martykube/maiana/latest/CAD/UARTBreakout/jlcpcb-3.0/uart-breakout-3.0-BOM-JLCPCB.csv

Comment | Designator | Footprint | LCSC Part #
1uF 50V X5R | C1,C2 | 0603 | C15849
0.1uF 50V X7R | C4,C5 | 0603 | C1591
SMBJ14CA | D1 | SMB | C152105
WSB5508L-2/TR | D2 | SOD-123 | C239542
BZT52C3V0S 3V zener | D3 | SOD-323 | C266575
BSMD1206-050-16V | F1 | 1206 | C883124
10118194-0001LF | J1 | USB Micro-B | C132563
75R | R8 | 0603 | C4275
CH340N | U$1 | SOIC-8 | C2977777
SRV05-4 | U$4 | SOT-23-6 | C2836319
SE8533X2-HF | U1 | SOT-23 | C115016
