martykube/maiana/latest/CAD/NMEA0183Breakout/Rev7.1/jlcpcb/nmea0183-adapter-7.1-BOM-JLCPCB.csv

Comment | Designator | Footprint | LCSC Part #
0.1uF 50V X7R | C1,C2,C3,C9,C10,C11 | 0603 | C1591
1uF 50V X5R | C4,C5,C6,C7,C8 | 0603 | C15849
WSB5508L-2/TR | D1 | SOD-123 | C239542
SMBJ16CA | D2 | SMB | C113990
RJ45 FG RJ-055-1 | J1 | RJ-82A86MMNL | C7205195
10118194-0001LF | J3 | USB_Micro-B | C132563
LED green | LED1,LED2,LED3,LED4 | 1206 | C14641
BSS138LT1G | Q1 | SOT-23 | C82045
AO3401A | Q2 | SOT-23 | C15127
10k | R1,R2 | 0603 | C25804
2.2k | R3,R4,R5,R6 | 0603 | C4190
BSMD1206-050-16V | TH1 | 1206 | C883124
SRV05-4 | U1 | SOT-23-6 | C2836319
CH340N | U2 | SO-8 | C2977777
ADUM121N1BRZ-RL7 | U3 | SOIC-8 | C190783
TJ5205SF5-5.0 | U4 | SOT-23-5 | C126091
SE8533X2-HF | U5 | SOT-23 | C115016
DS8921M/NOPB | U6 | SOIC-8 | C133584
