martykube/maiana/latest/CAD/NMEA2000Breakout/Rev8.1/jlcpcb/nmea2000-adapter-8.1-BOM-JLCPCB.csv

Comment | Designator | Footprint | LCSC Part #
0.1uF 50V X7R | C1,C2,C3,C11,C12,C13 | 0603 | C1591
20pF 50V C0G | C4,C5 | 0603 | C91702
1uF 50V X5R | C6,C7,C8,C9,C10 | 0603 | C15849
LED green | D1,D2,D3,D4 | 1206 | C14641
PESD1CAN-UX | D5 | SOT-323 | C152727
SMBJ16CA | D6 | SMB | C113990
B5819W SL | D8 | SOD-123 | C8598
RJ45 FG RJ-055-1 | J2 | RJ-82A86MMNL | C7205195
10118194-0001LF | J3 | USB_Micro-B | C132563
BSS138LT1G | Q1,Q3 | SOT-23 | C82045
AO3401A | Q2 | SOT-23 | C15127
2.2k | R1,R2,R3,R4 | 0603 | C4190
10k | R5,R6,R7,R8,R9,R10 | 0603 | C25804
0R | R11,R12 | 0603 | C21189
CL-SB-12B-01 | SW1,SW2 | CL-SB-12B-01T | C5619703
1977066-1 | SW3 | TE_1977066-1 | C2972219
BSMD1206-050-16V | TH1 | 1206 | C883124
STM32L432KBU6 | U1 | QFN-32 | C94784
MCP2515-I/ST | U2 | TSSOP-20 | C15193
MCP2551-I/SN | U3 | SOIC-8 | C7376
SRV05-4 | U4 | SOT-23-6 | C2836319
CH340N | U5 | SO-8 | C2977777
ISO7721DR | U6 | SOIC-8 | C366164
TJ5205SF5-5.0 | U7 | SOT-23-5 | C126091
SE8533X2-HF | U8 | SOT-23 | C115016
X322516MOB4SI 16MHz | Y1 | 3225 | C12668
