martykube/maiana/latest/CAD/Board-12.0.1/jlcpcb/transponder-12.0.1-BOM-JLCPCB.csv

Comment | Designator | Footprint | LCSC
1575AT43A0040001E | AE1 | ANT_1575AT_JOT
91pF | C2 | C_0603_1608Metric | C701317
36pF | C15 | C_0603_1608Metric | C134070
2.2nF | C16 | C_0603_1608Metric | C77033
20pF | C21 | C_0603_1608Metric | C77030
16pF | C22 | C_0603_1608Metric | C327125
10uF | C29 | C_0805_2012Metric | C18185759
4pF | C32 | C_0603_1608Metric | C437534
2.2pF | C33 | C_0603_1608Metric | C282246
2pF | C1,C37 | C_0603_1608Metric | C81437
470pF | C13,C18,C20 | C_0603_1608Metric | C85979
110pF | C14,C17 | C_0603_1608Metric | C327208
22nF | C19,C31 | C_0603_1608Metric | C106222
22uF | C28,C38 | C_0805_2012Metric | C20416420
0.1uF,0.1uf | C3,C9,C11,C27,C34,C35 | C_0603_1608Metric | C14663
7.5pF | C4,C36 | C_0402_1005Metric | C88938
13pF | C5,C6 | C_0402_1005Metric | C130119
2.2uF | C7,C10,C23,C24,C25,C26,C30,C39 | C_0603_1608Metric | C380321
100pF | C8,C12 | C_0603_1608Metric | C71664
D3V3X8U9LP3810-7 | CR1 | U-DFN3810-9TYPE_B_DIO | C1973794
SMBJ16CA | D1 | DIOM4336X265N | C113990
BAT54WS | D3,D4 | D_SOD-323 | C124205
LDFPVR | IC1 | SON65P200X200X100-7N-D | C2969978
CON-SMA-EDGE-S | J3 | RFSOLUTIONS_CON-SMA-EDGE-S
RJ-82A86MMNL | J4 | RJ-82A86MMNL | C7205195
2.2uH AFL160808-2R2MLH | L4 | L_0603_1608Metric | C55265173
13nH | L5 | L_0603_1608Metric | C701184
39nH | L6 | L_0603_1608Metric | C86134
20nH | L7 | L_0603_1608Metric | C77124
47nH | L10 | L_0603_1608Metric | C98076
68nH | L11 | L_0603_1608Metric | C86135
22uH | L12 | L_1210_3225Metric | C307600
5.6nH | L14 | L_0603_1608Metric | C98081
470nH | L1,L8,L9 | L_0603_1608Metric | C113132
180nH | L15,L16 | L_0603_1608Metric | C98091
200nH | L2,L3 | L_0402_1005Metric | C2045944
AFT05MS004NT1 | Q1 | SOT-89-3 | C713822
AO3401A | Q2,Q7 | SOT-23 | C15127
3k3 | R3 | R_0603_1608Metric | C22978
22R | R4 | R_0603_1608Metric | C23345
1k1 | R1,R17,R18 | R_0603_1608Metric | C22764
100R | R12,R13,R14,R15,R16 | R_0603_1608Metric | C22775
10k | R2,R6,R10,R11 | R_0603_1608Metric | C25804
47k | R5,R9 | R_0603_1608Metric | C25819
PSA4-5043+ | U3 | PSA4-5043_ | C5240848
L76L-M33 | U4 | XCVR_L76L-M33 | C2916232
STM32L412KBU6 | U5 | QFN-32-1EP_5x5mm_P0.5mm_EP3.45x3.45mm | C529439
AP63205WU | U6 | TSOT-23-6 | C2071056
24LC01BT/OT | U7 | SOT-23-5 | C511269
SKY13330-397LF | U8 | QFN50P200X200X65-13N | C2654715
TB0436A | U11 | TB0436A
NCP163ASN330T1G | U12 | SOT-23-5 | C603656
Si4460 | U1,U2 | QFN-20-1EP_4x4mm_P0.5mm_EP2.6x2.6mm_ThermalVias | C2151590
DMN63D8LDW-7 | U9,U10 | SOT-363_SC-70-6 | C211422
ECS-300-10-33B-CKM-TR | Y1,Y2 | Crystal_SMD_3225-4Pin_3.2x2.5mm
FTSH-105-01-L-DV-K-TR | J2 | PinHeader_2x05_P1.27mm_Vertical_SMD | C448647
