martykube/maiana/latest/CAD/NMEA0183Breakout/Rev7.1/NMEA0183Adapter-7.1.kicad_pcb

## KiCad design latest/CAD/NMEA0183Breakout/Rev7.1/NMEA0183Adapter-7.1.kicad_pcb (2026-11-01)

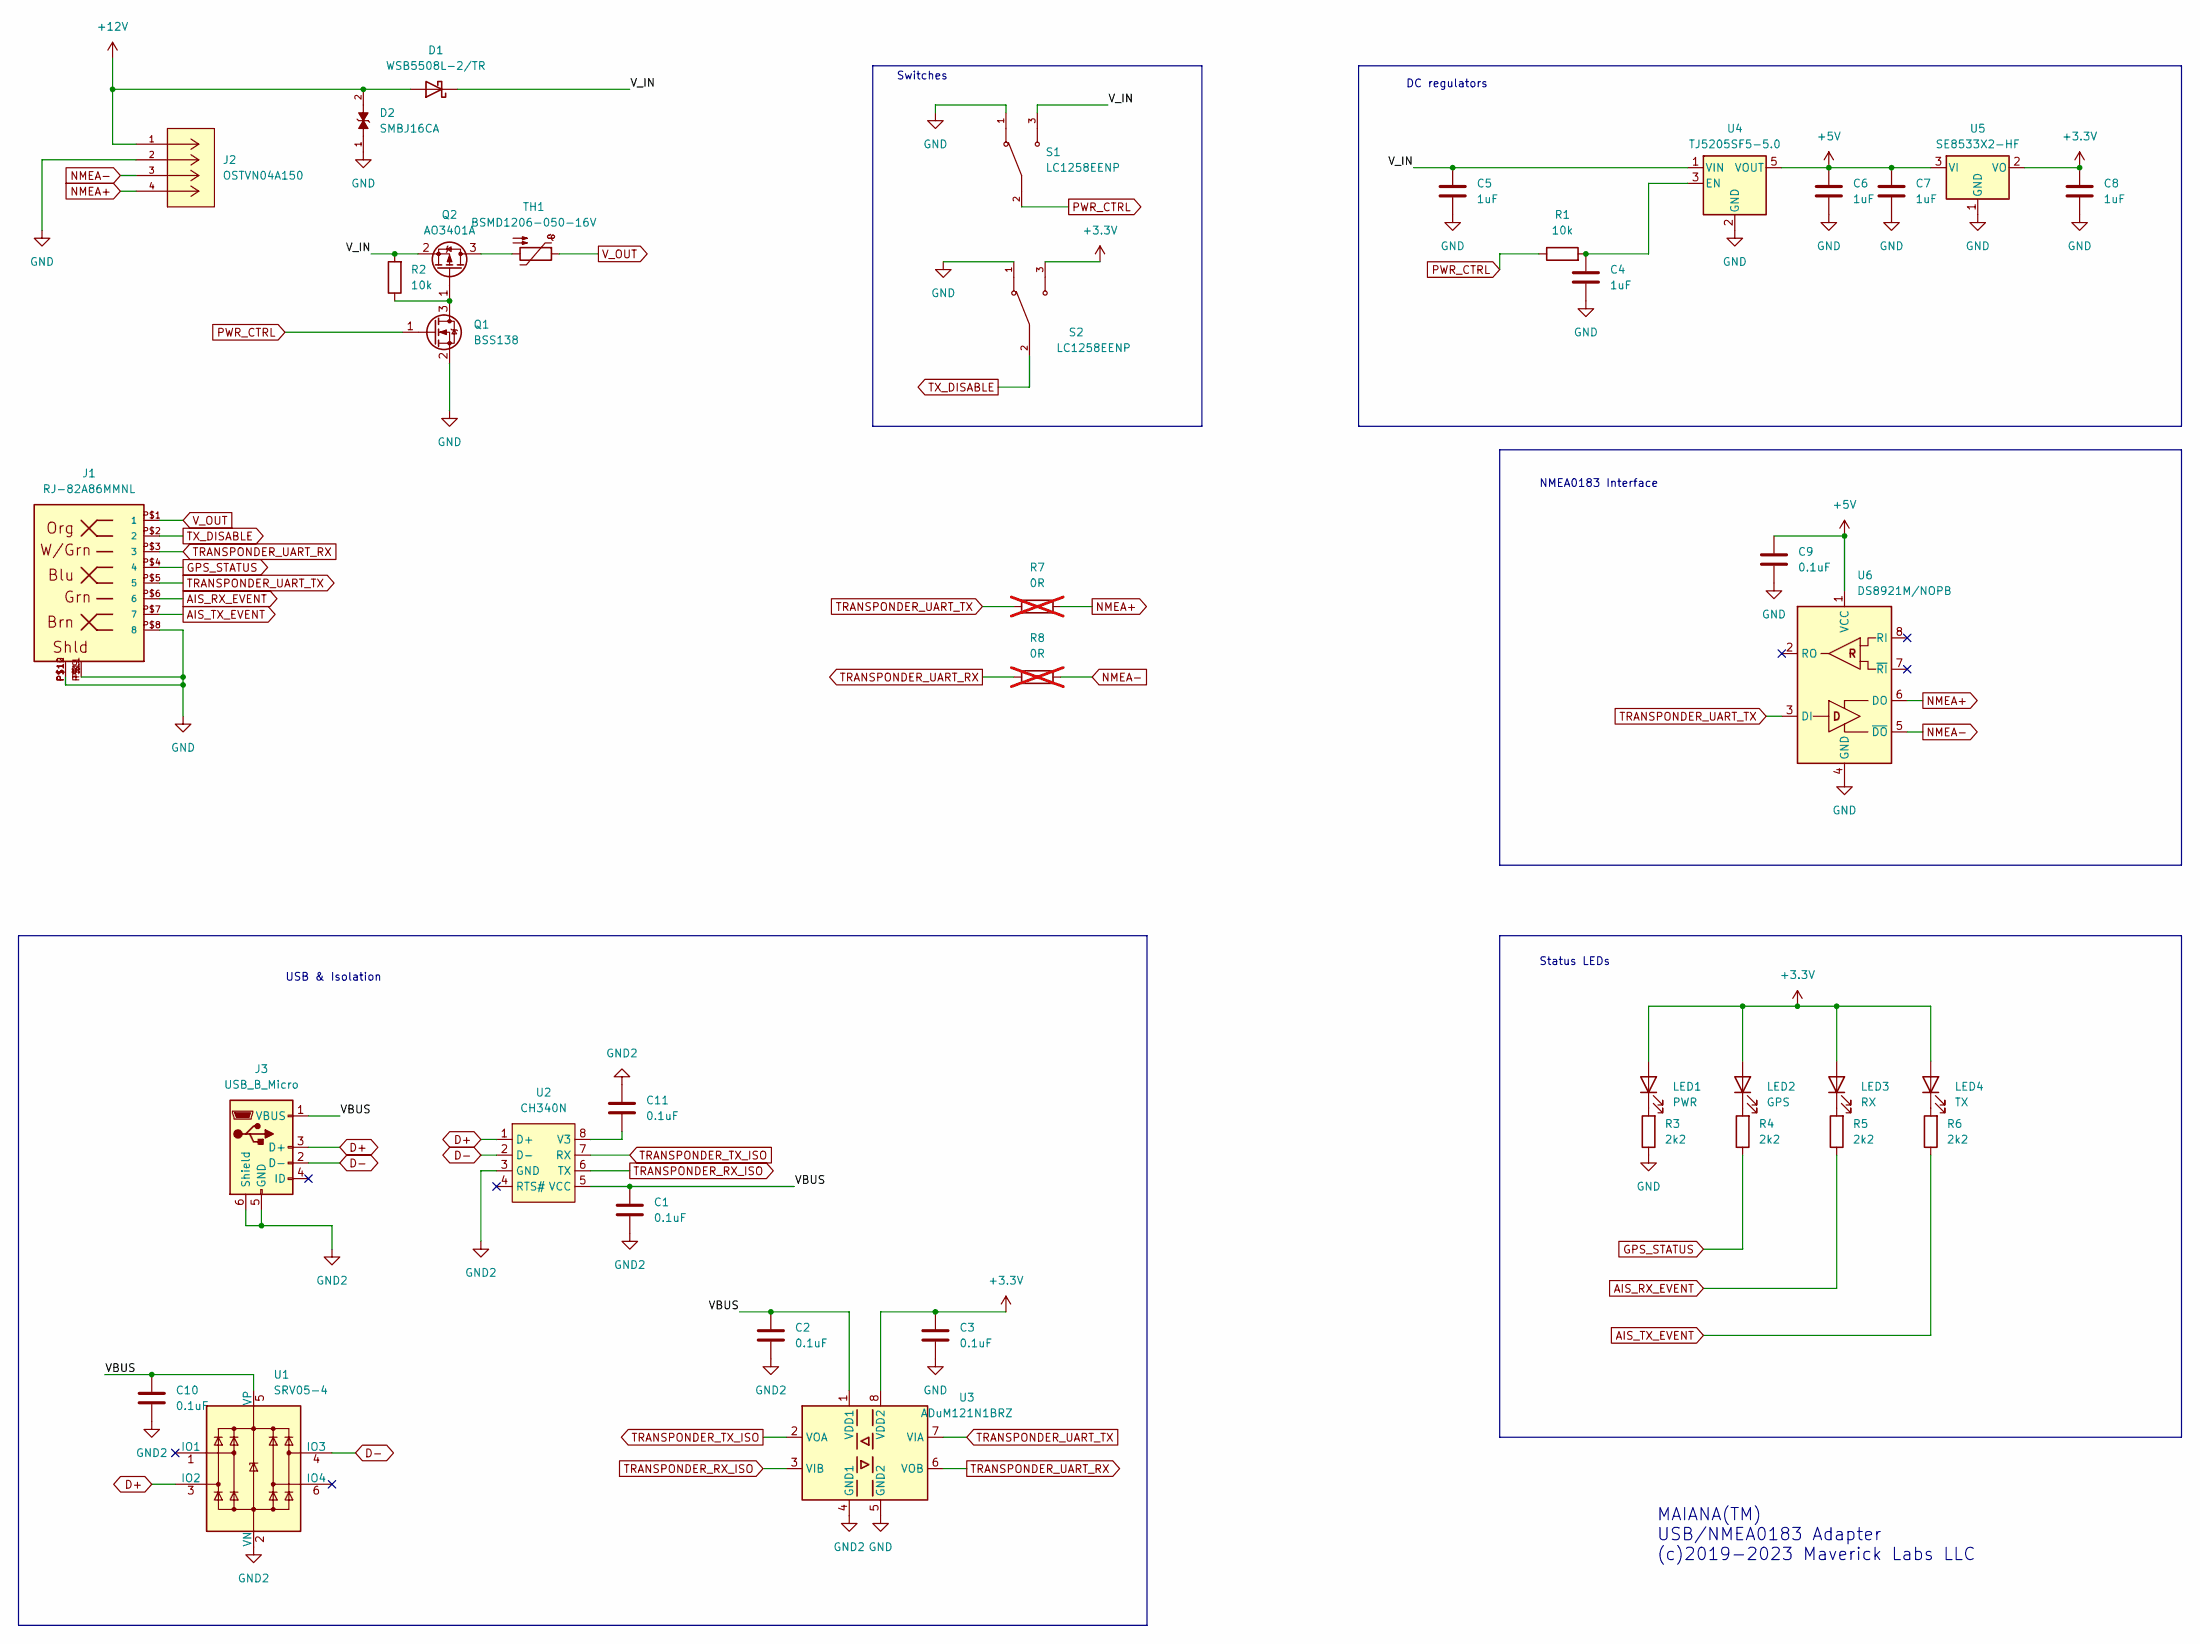
[picture p1: schematic NMEA0183Adapter-7.1.kicad_sch]

Parts:
C1, C2, C3, C9, C10, C11: 0.1uF; C_0603_1608Metric; LCSC C1591
C4, C5, C6, C7, C8: 1uF; C_0603_1608Metric; LCSC C15849
D1: WSB5508L-2/TR; D_SOD-123; LCSC C239542
D2: SMBJ16CA; DIOM4336X265N; PARTREV I2102; LCSC C113990
J1: RJ-82A86MMNL; PARTNO RJ-82A86MMNL; LCSC C7205195
J2: OSTVN04A150; CONN_OSTVN04A150_OST; MANUFACTURER_PART_NUMBER OSTVN04A150; DIGI-KEY_PART_NUMBER_1 ED10563-ND
J3: USB_B_Micro; USB_Micro-B_Amphenol_10118194_Horizontal; LCSC C132563
LED1: PWR; LED_1206_3216Metric; LCSC C14641
LED2: GPS; LED_1206_3216Metric; LCSC C14641
LED3: RX; LED_1206_3216Metric; LCSC C14641
LED4: TX; LED_1206_3216Metric; LCSC C14641
Q1: BSS138; SOT-23; LCSC C82045
Q2: AO3401A; SOT-23; LCSC C15127
R1, R2: 10k; R_0603_1608Metric; LCSC C25804
R3, R4, R5, R6: 2k2; R_0603_1608Metric; LCSC C4190
R7, R8: 0R; R_0603_1608Metric; not fitted
S1, S2: LC1258EENP; SW_LC1258EENP; PARTREV C
TH1: BSMD1206-050-16V; R_1206_3216Metric; LCSC C883124
U1: SRV05-4; SOT-23-6; LCSC C2836319
U2: CH340N; SO-8_3.9x4.9mm_P1.27mm; LCSC C2977777
U3: ADuM121N1BRZ; SOIC-8_3.9x4.9mm_P1.27mm; LCSC C190783
U4: TJ5205SF5-5.0; SOT-23-5; LCSC C126091
U5: SE8533X2-HF; SOT-23; LCSC C115016
U6: DS8921M/NOPB; SOIC-8_3.9x4.9mm_P1.27mm; LCSC C133584

Connections:
+3.3V: C3.1, C8.1, LED1.2 (A), LED2.2 (A), LED3.2 (A), LED4.2 (A), S2.3, U3.8 (VDD2), U5.2 (VO)
+5V: C6.1, C7.1, C9.1, U4.5 (VOUT), U5.3 (VI), U6.1 (VCC)
+12V: D1.2 (A), D2.2, J2.1
/VBUS: C1.1, C2.1, C10.1, J3.1 (VBUS), U1.5 (VP), U2.5 (VCC), U3.1 (VDD1)
/V_IN: C5.1, D1.1 (K), Q2.2 (S), R2.2, S1.3, U4.1 (VIN)
AIS_RX_EVENT: J1.P$6 (6), R5.1
AIS_TX_EVENT: J1.P$7 (7), R6.1
D+: J3.3 (D+), U1.3 (IO2), U2.1 (D+)
D-: J3.2 (D-), U1.4 (IO3), U2.2 (D-)
GND: C3.2, C4.2, C5.2, C6.2, C7.2, C8.2, C9.2, D2.1, J1.P$8 (8), J1.P$9, J1.P$10, J1.P$11, J1.P$12, J2.2, Q1.2 (S), R3.1, S1.1, S2.1, U3.5 (GND2), U4.2 (GND), U5.1 (GND), U6.4 (GND)
GND2: C1.2, C2.2, C10.2, C11.1, J3.5 (GND), J3.6 (Shield), U1.2 (VN), U2.3 (GND), U3.4 (GND1)
GPS_STATUS: J1.P$4 (4), R4.1
NMEA+: J2.4, R7.1, U6.6 (DO)
NMEA-: J2.3, R8.1, U6.5 (~DO)
unnamed: LED1.1 (K), R3.2
unnamed: LED2.1 (K), R4.2
unnamed: LED3.1 (K), R5.2
unnamed: LED4.1 (K), R6.2
unnamed: Q1.3 (D), Q2.1 (G), R2.1
unnamed: Q2.3 (D), TH1.2
unnamed: C11.2, U2.8 (V3)
unnamed: C4.1, R1.2, U4.3 (EN)
PWR_CTRL: Q1.1 (G), R1.1, S1.2
TRANSPONDER_RX_ISO: U2.6 (TX), U3.3 (VIB)
TRANSPONDER_TX_ISO: U2.7 (RX), U3.2 (VOA)
TRANSPONDER_UART_RX: J1.P$3 (3), R8.2, U3.6 (VOB)
TRANSPONDER_UART_TX: J1.P$5 (5), R7.2, U3.7 (VIA), U6.3 (DI)
TX_DISABLE: J1.P$2 (2), S2.2
V_OUT: J1.P$1 (1), TH1.1

Notes on the sheet:
USB & Isolation
Status LEDs
MAIANA(TM) USB/NMEA0183 Adapter (c)2019-2023 Maverick Labs LLC
NMEA0183 Interface
DC regulators
Switches

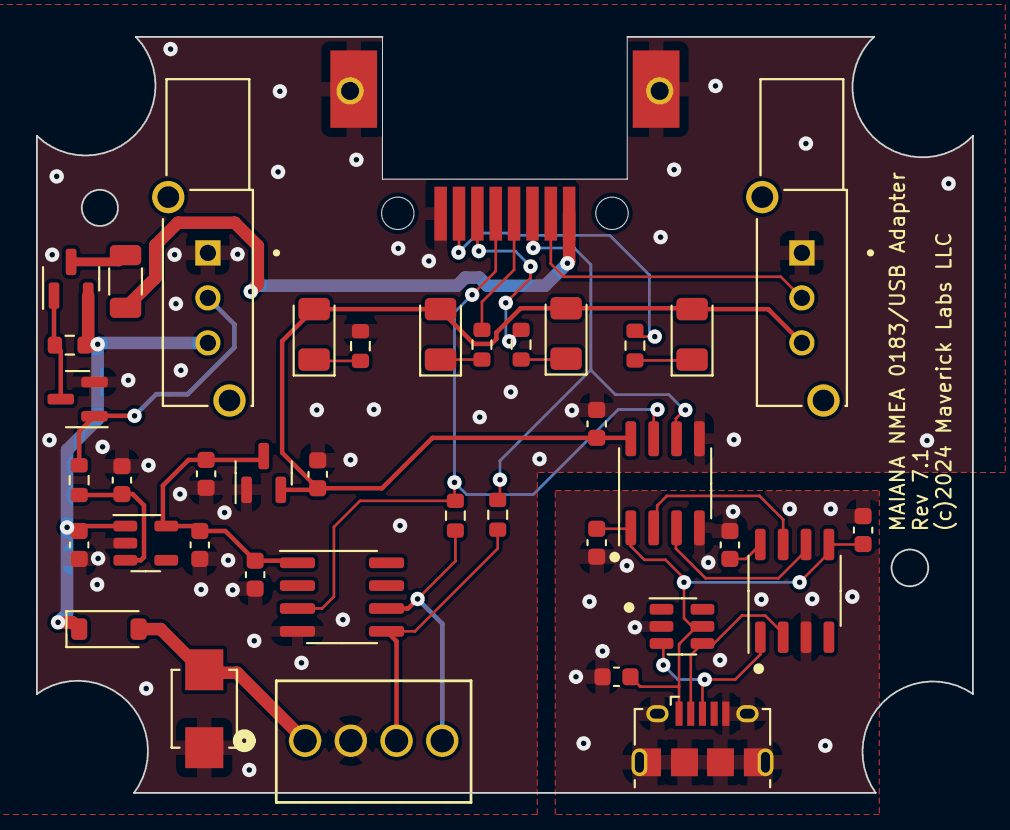
[picture p2: board NMEA0183Adapter-7.1.kicad_pcb from above]

Board: 2 copper layers, 52.0 x 42.0 mm, 39 parts (0 on the bottom side), 29 nets.
