martykube/maiana/latest/CAD/Board-12.0.1/transponder-12.0.1.kicad_pcb

## KiCad design latest/CAD/Board-12.0.1/transponder-12.0.1.kicad_pcb (2026-11-06)

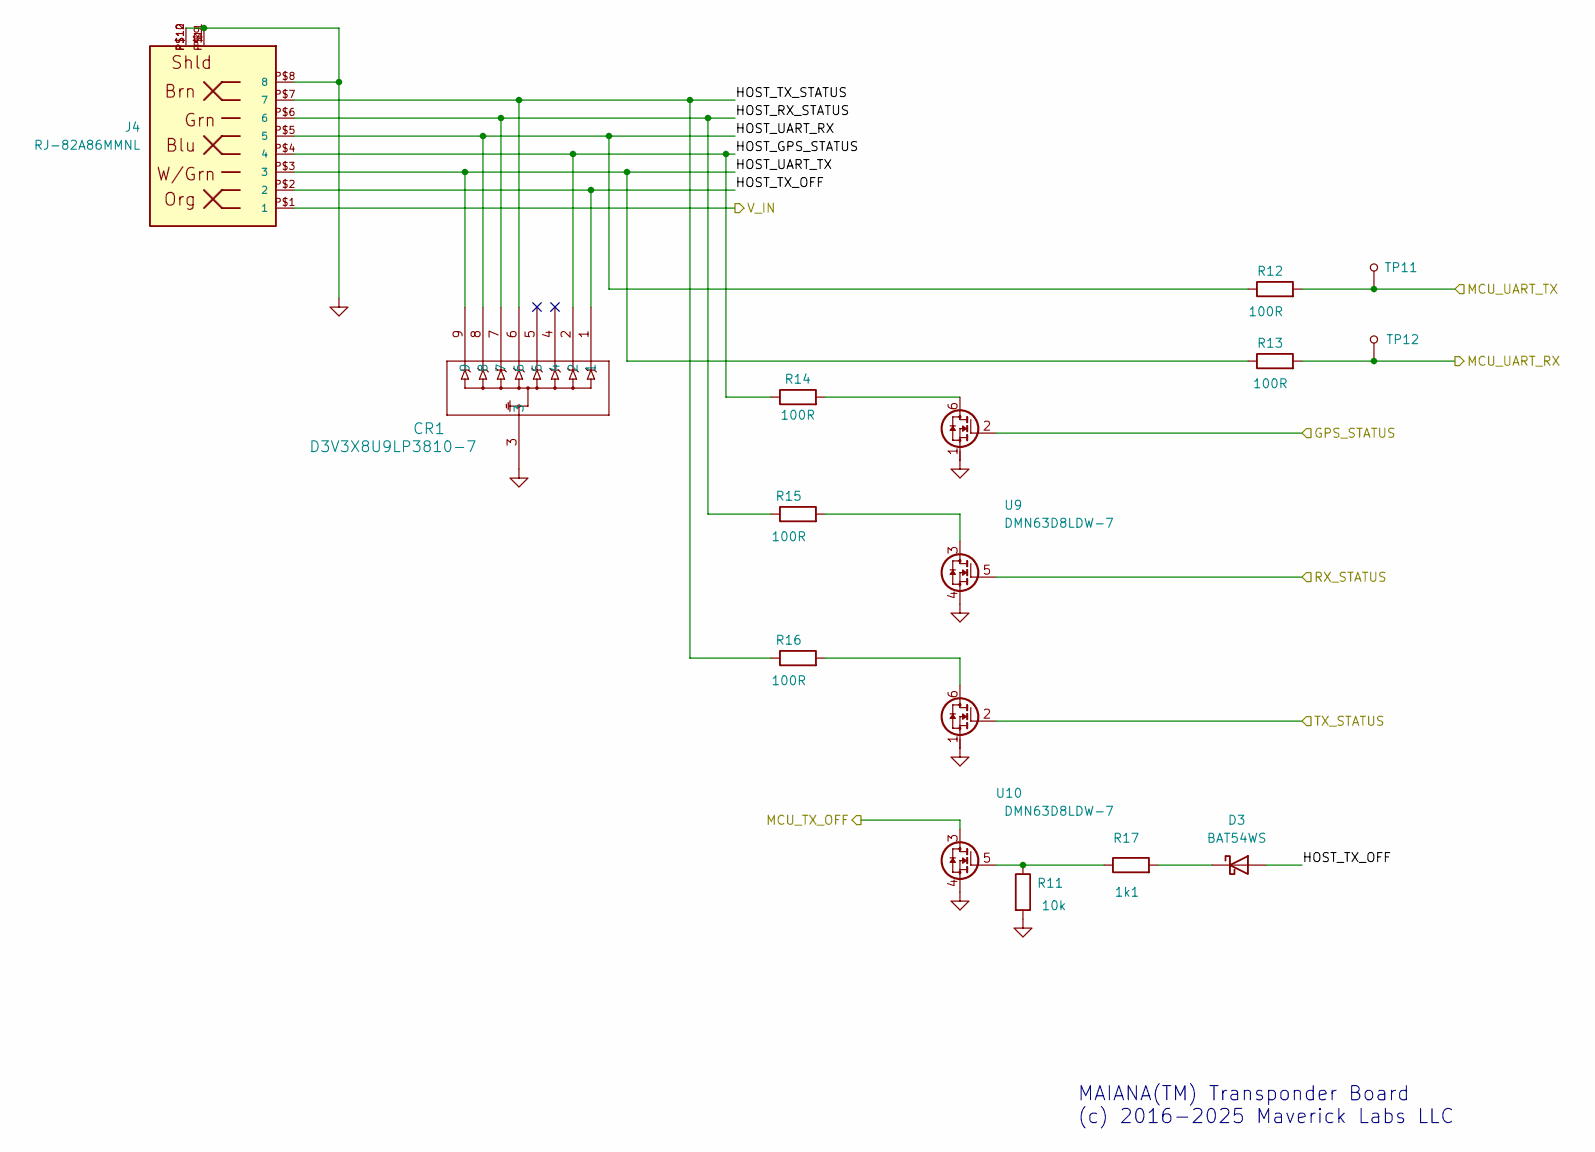
[picture p3: schematic connections.kicad_sch, Off Board Connections]

Parts:
CR1: D3V3X8U9LP3810-7; U-DFN3810-9TYPE_B_DIO; LCSC C1973794
D3: BAT54WS; D_SOD-323; LCSC C124205
J4: RJ-82A86MMNL; PARTNO RJ-82A86MMNL; LCSC C7205195
R11: 10k; R_0603_1608Metric; LCSC C25804
R12, R13, R14, R15, R16: 100R; R_0603_1608Metric; LCSC C22775
R17: 1k1; R_0603_1608Metric; LCSC C22764
TP11, TP12: TP_1.2MM
U9, U10: DMN63D8LDW-7; SOT-363_SC-70-6; LCSC C211422

Connections:
/Connections/GPS_STATUS: U9.2 (G1); also elsewhere on the board
/Connections/HOST_GPS_STATUS: CR1.2, J4.P$4 (4), R14.1
/Connections/HOST_RX_STATUS: CR1.7, J4.P$6 (6), R15.1
/Connections/HOST_TX_OFF: CR1.1, D3.2 (A), J4.P$2 (2)
/Connections/HOST_TX_STATUS: CR1.6, J4.P$7 (7), R16.1
/Connections/HOST_UART_RX: CR1.8, J4.P$5 (5), R12.1
/Connections/HOST_UART_TX: CR1.9, J4.P$3 (3), R13.1
/Connections/MCU_TX_OFF: U10.3 (D2); also elsewhere on the board
/Connections/MCU_UART_RX: R13.2, TP12.1; also elsewhere on the board
/Connections/MCU_UART_TX: R12.2, TP11.1; also elsewhere on the board
/Connections/RX_STATUS: U9.5 (G2); also elsewhere on the board
/Connections/TX_STATUS: U10.2 (G1); also elsewhere on the board
/Connections/V_IN: J4.P$1 (1); also elsewhere on the board
GND: CR1.3, J4.P$8 (8), J4.P$9, J4.P$10, J4.P$11, J4.P$12, R11.2, U9.1 (S1), U9.4 (S2), U10.1 (S1), U10.4 (S2); also elsewhere on the board
unnamed: D3.1 (K), R17.2
unnamed: R14.2, U9.6 (D1)
unnamed: R15.2, U9.3 (D2)
unnamed: R16.2, U10.6 (D1)
unnamed: R11.1, R17.1, U10.5 (G2)

Notes on the sheet:
MAIANA(TM) Transponder Board (c) 2016-2025 Maverick Labs LLC

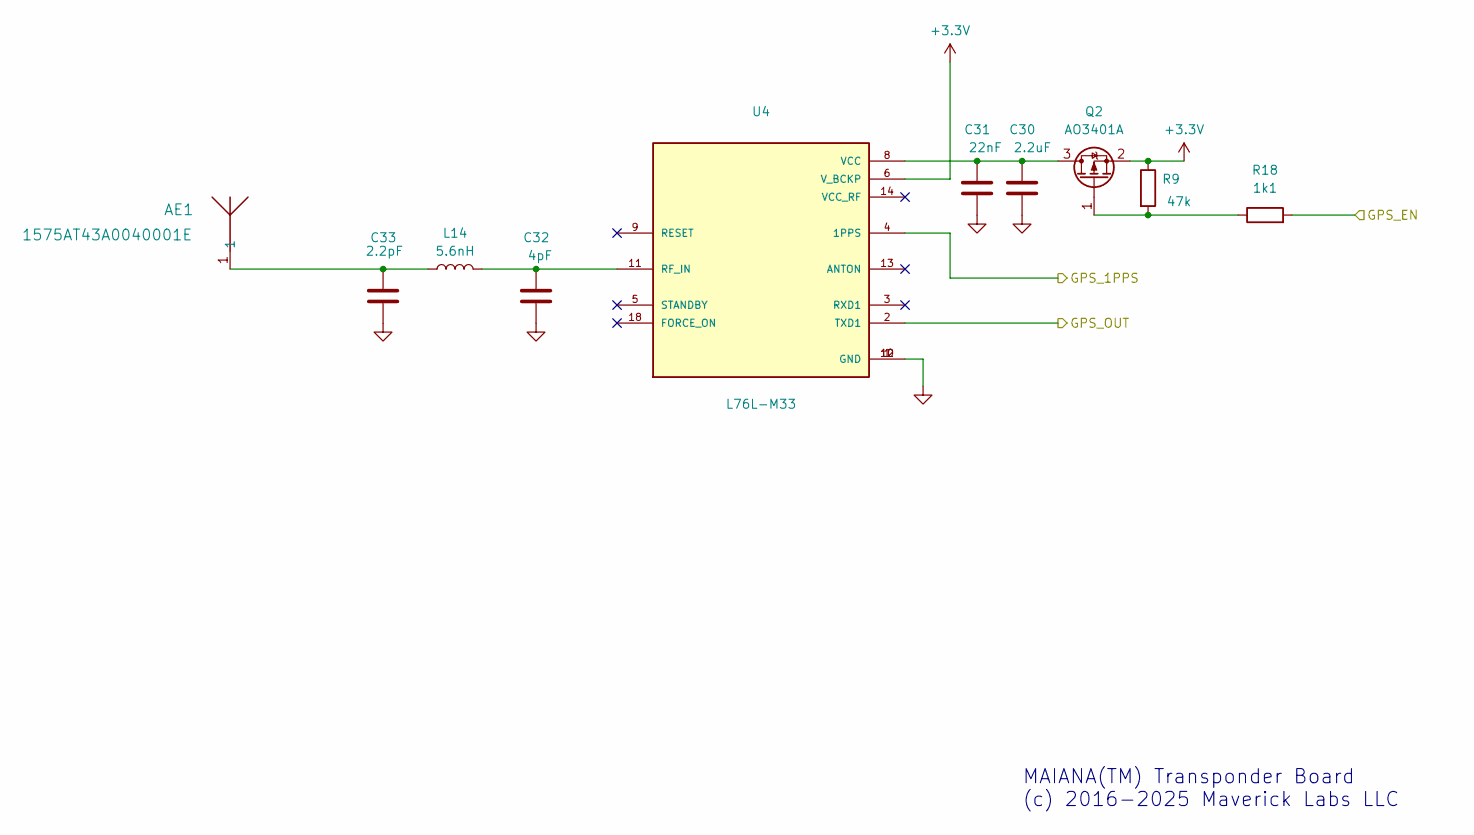
[picture p4: schematic gnss.kicad_sch]

Parts:
AE1: 1575AT43A0040001E; ANT_1575AT_JOT
C30: 2.2uF; C_0603_1608Metric; LCSC C380321
C31: 22nF; C_0603_1608Metric; LCSC C106222
C32: 4pF; C_0603_1608Metric; LCSC C437534
C33: 2.2pF; C_0603_1608Metric; LCSC C282246
L14: 5.6nH; L_0603_1608Metric; LCSC C98081
Q2: AO3401A; SOT-23; LCSC C15127
R9: 47k; R_0603_1608Metric; LCSC C25819
R18: 1k1; R_0603_1608Metric; LCSC C22764
U4: L76L-M33; XCVR_L76L-M33; LCSC C2916232

Connections:
+3.3V: Q2.2 (S), R9.1, U4.6 (V_BCKP); also elsewhere on the board
/GNSS/GPS_1PPS: U4.4 (1PPS); also elsewhere on the board
/GNSS/GPS_EN: R18.2; also elsewhere on the board
/GNSS/GPS_OUT: U4.2 (TXD1); also elsewhere on the board
GND: C30.1, C31.1, C32.1, C33.1, U4.1 (GND), U4.10 (GND), U4.12 (GND); also elsewhere on the board
unnamed: AE1.1, C33.2, L14.1
unnamed: C30.2, C31.2, Q2.3 (D), U4.8 (VCC)
unnamed: Q2.1 (G), R9.2, R18.1
unnamed: C32.2, L14.2, U4.11 (RF_IN)

Notes on the sheet:
MAIANA(TM) Transponder Board (c) 2016-2025 Maverick Labs LLC

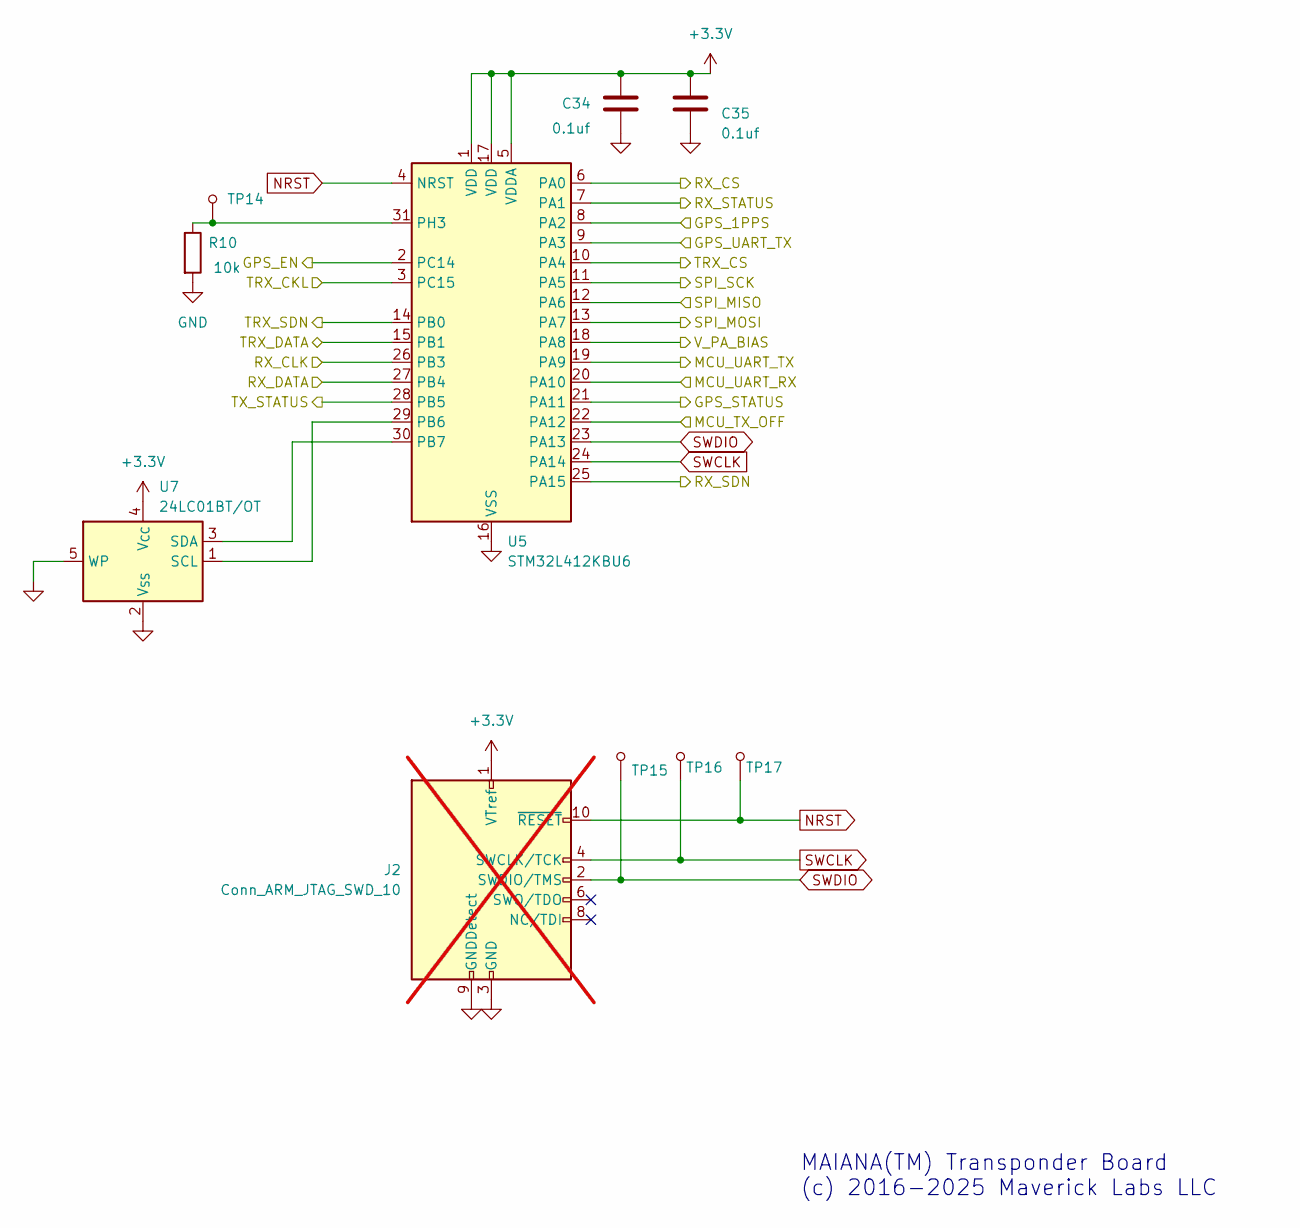
[picture p5: schematic mcu.kicad_sch]

Parts:
C34, C35: 0.1uf; C_0603_1608Metric; LCSC C14663
J2: Conn_ARM_JTAG_SWD_10; PinHeader_2x05_P1.27mm_Vertical_SMD; LCSC C5155080; not fitted
R10: 10k; R_0603_1608Metric; LCSC C25804
TP14, TP15, TP16, TP17: TP_1.2MM
U5: STM32L412KBU6; QFN-32-1EP_5x5mm_P0.5mm_EP3.45x3.45mm; LCSC C529439
U7: 24LC01BT/OT; SOT-23-5; LCSC C511269

Connections:
+3.3V: C34.2, C35.2, J2.1 (VTref), U5.1 (VDD), U5.5 (VDDA), U5.17 (VDD), U7.4 (V_{CC}); also elsewhere on the board
/Connections/GPS_STATUS: U5.21 (PA11); also elsewhere on the board
/Connections/MCU_TX_OFF: U5.22 (PA12); also elsewhere on the board
/Connections/MCU_UART_RX: U5.20 (PA10); also elsewhere on the board
/Connections/MCU_UART_TX: U5.19 (PA9); also elsewhere on the board
/Connections/RX_STATUS: U5.7 (PA1); also elsewhere on the board
/Connections/TX_STATUS: U5.28 (PB5); also elsewhere on the board
/GNSS/GPS_1PPS: U5.8 (PA2); also elsewhere on the board
/GNSS/GPS_EN: U5.2 (PC14); also elsewhere on the board
/GNSS/GPS_OUT: U5.9 (PA3); also elsewhere on the board
/MCU/RX_CLK: U5.26 (PB3); also elsewhere on the board
/MCU/RX_CS: U5.6 (PA0); also elsewhere on the board
/MCU/RX_DATA: U5.27 (PB4); also elsewhere on the board
/MCU/RX_SDN: U5.25 (PA15); also elsewhere on the board
/MCU/SPI_MISO: U5.12 (PA6); also elsewhere on the board
/MCU/SPI_MOSI: U5.13 (PA7); also elsewhere on the board
/MCU/SPI_SCK: U5.11 (PA5); also elsewhere on the board
/MCU/TRX_CKL: U5.3 (PC15); also elsewhere on the board
/MCU/TRX_CS: U5.10 (PA4); also elsewhere on the board
/MCU/TRX_DATA: U5.15 (PB1); also elsewhere on the board
/MCU/TRX_SDN: U5.14 (PB0); also elsewhere on the board
/MCU/V_PA_BIAS: U5.18 (PA8); also elsewhere on the board
GND: C34.1, C35.1, J2.3 (GND), J2.5 (GND), J2.9 (GNDDetect), R10.2, U5.16 (VSS), U5.32 (VSS), U5.33 (VSS), U7.2 (V_{SS}), U7.5 (WP); also elsewhere on the board
NRST: J2.10 (~RESET), TP17.1, U5.4 (NRST)
unnamed: R10.1, TP14.1, U5.31 (PH3)
unnamed: U5.29 (PB6), U7.1 (SCL)
unnamed: U5.30 (PB7), U7.3 (SDA)
SWCLK: J2.4 (SWCLK/TCK), TP16.1, U5.24 (PA14)
SWDIO: J2.2 (SWDIO/TMS), TP15.1, U5.23 (PA13)

Notes on the sheet:
MAIANA(TM) Transponder Board (c) 2016-2025 Maverick Labs LLC

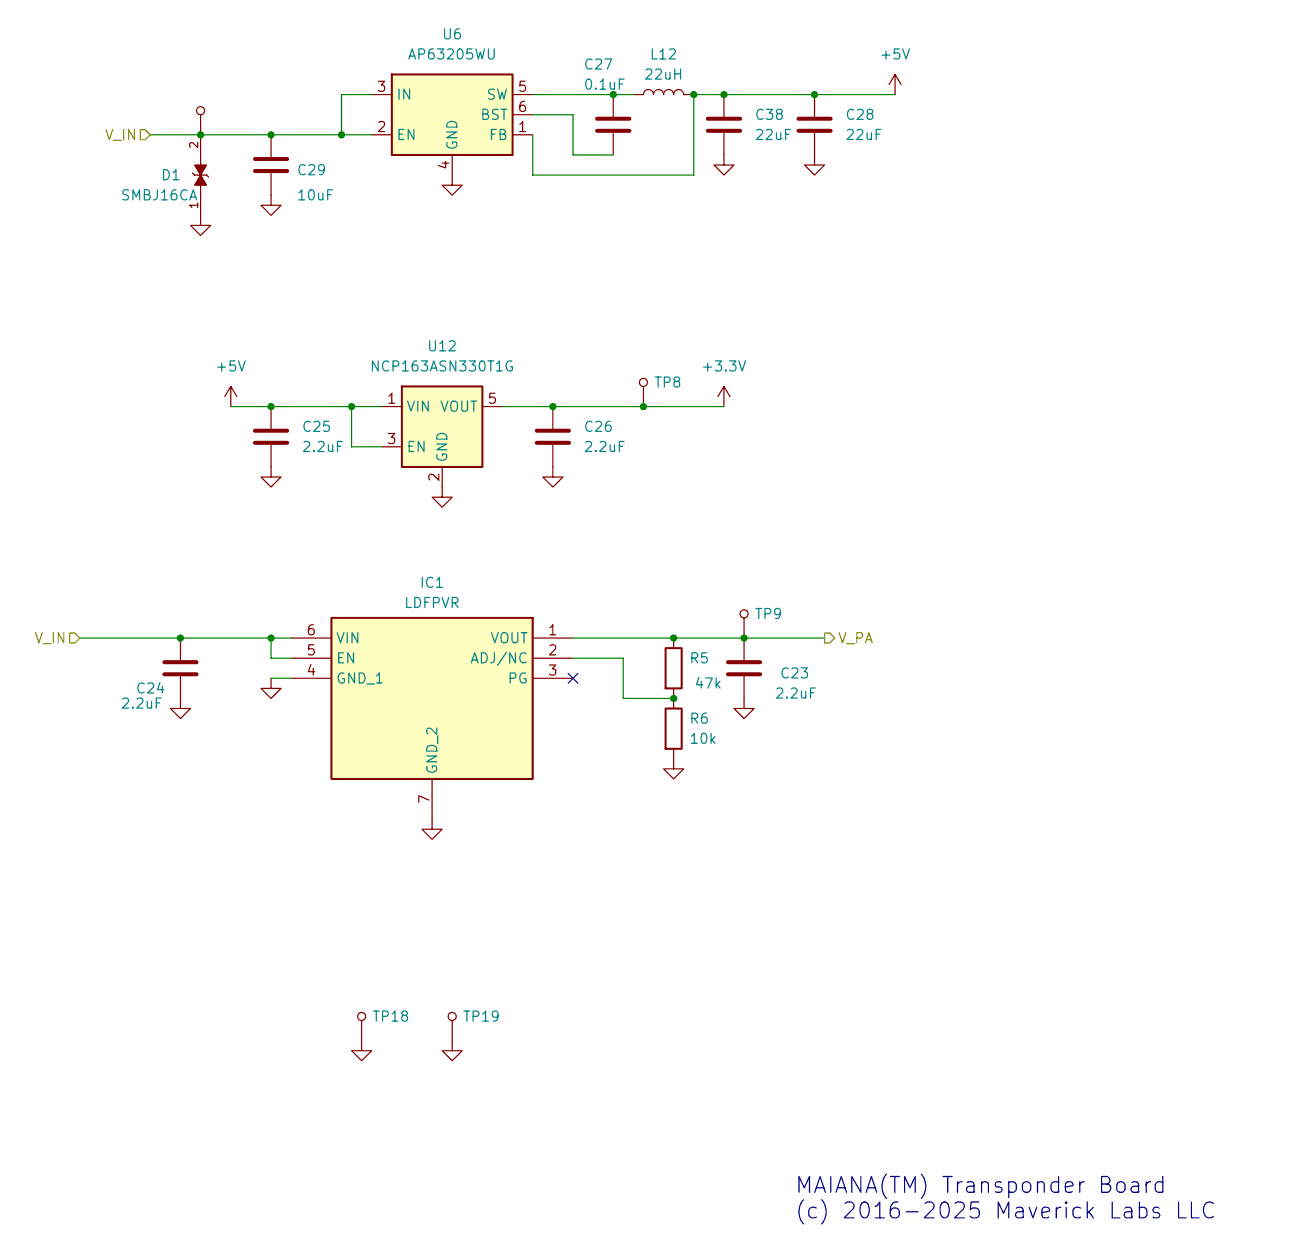
[picture p6: schematic power.kicad_sch, Power Supply]

Parts:
C23, C24, C25, C26: 2.2uF; C_0603_1608Metric; LCSC C380321
C27: 0.1uF; C_0603_1608Metric; LCSC C14663
C28, C38: 22uF; C_0805_2012Metric; LCSC C20416420
C29: 10uF; C_0805_2012Metric; LCSC C18185759
D1: SMBJ16CA; DIOM4336X265N; PARTREV I2102; LCSC C113990
IC1: LDFPVR; SON65P200X200X100-7N-D; Mouser Part Number 511-LDFPVR; LCSC C2969978
L12: 22uH; L_1210_3225Metric; LCSC C307600
R5: 47k; R_0603_1608Metric; LCSC C25819
R6: 10k; R_0603_1608Metric; LCSC C25804
TP8, TP9, TP10, TP18, TP19: TP_1.2MM
U6: AP63205WU; TSOT-23-6; LCSC C2071056
U12: NCP163ASN330T1G; SOT-23-5; LCSC C603656

Connections:
+3.3V: C26.1, TP8.1, U12.5 (VOUT); also elsewhere on the board
+5V: C25.1, C28.1, C38.1, L12.2, U6.1 (FB), U12.1 (VIN), U12.3 (EN)
/Connections/V_IN: C24.2, C29.1, D1.2, IC1.5 (EN), IC1.6 (VIN), TP10.1, U6.2 (EN), U6.3 (IN); also elsewhere on the board
/Power/V_PA: C23.2, IC1.1 (VOUT), R5.1, TP9.1; also elsewhere on the board
GND: C23.1, C24.1, C25.2, C26.2, C28.2, C29.2, C38.2, D1.1, IC1.4 (GND_1), IC1.7 (GND_2), R6.2, TP18.1, TP19.1, U6.4 (GND), U12.2 (GND); also elsewhere on the board
unnamed: IC1.2 (ADJ/NC), R5.2, R6.1
unnamed: C27.1, U6.6 (BST)
unnamed: C27.2, L12.1, U6.5 (SW)

Notes on the sheet:
MAIANA(TM) Transponder Board (c) 2016-2025 Maverick Labs LLC

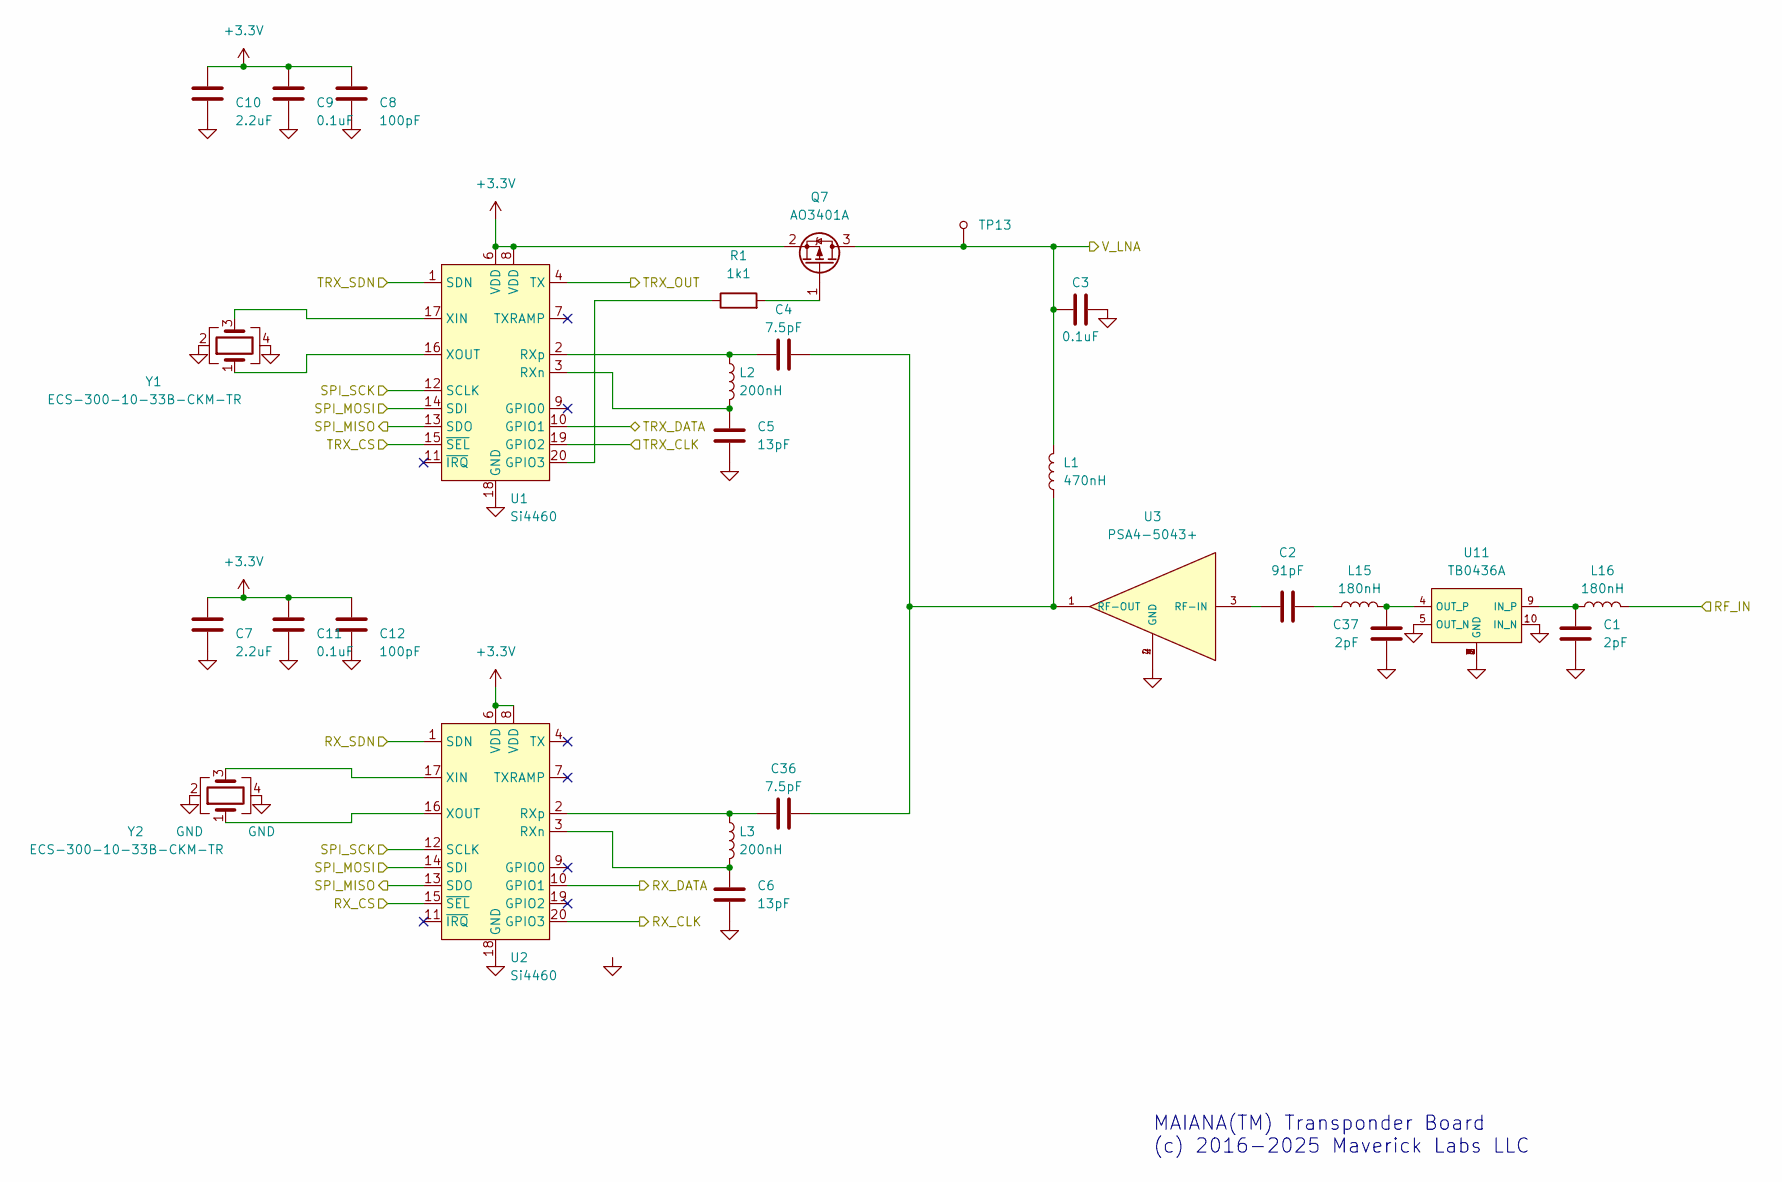
[picture p7: schematic rx.kicad_sch, Receiver Chain]

Parts:
C1, C37: 2pF; C_0603_1608Metric; LCSC C81437
C2: 91pF; C_0603_1608Metric; LCSC C701317
C3, C9, C11: 0.1uF; C_0603_1608Metric; LCSC C14663
C4, C36: 7.5pF; C_0402_1005Metric; LCSC C88938
C5, C6: 13pF; C_0402_1005Metric; LCSC C130119
C7, C10: 2.2uF; C_0603_1608Metric; LCSC C380321
C8, C12: 100pF; C_0603_1608Metric; LCSC C71664
L1: 470nH; L_0603_1608Metric; LCSC C113132
L2, L3: 200nH; L_0402_1005Metric; LCSC C2045944
L15, L16: 180nH; L_0603_1608Metric; LCSC C98091
Q7: AO3401A; SOT-23; LCSC C15127
R1: 1k1; R_0603_1608Metric; LCSC C22764
TP13: TP_1.2MM
U1, U2: Si4460; QFN-20-1EP_4x4mm_P0.5mm_EP2.6x2.6mm_ThermalVias; LCSC C2151590
U3: PSA4-5043+; PSA4-5043_; LCSC C5240848
U11: TB0436A
Y1, Y2: ECS-300-10-33B-CKM-TR; Crystal_SMD_3225-4Pin_3.2x2.5mm

Connections:
+3.3V: C7.2, C8.2, C9.2, C10.2, C11.2, C12.2, Q7.2 (S), U1.6 (VDD), U1.8 (VDD), U2.6 (VDD), U2.8 (VDD); also elsewhere on the board
/MCU/RX_CLK: U2.20 (GPIO3); also elsewhere on the board
/MCU/RX_CS: U2.15 (~SEL); also elsewhere on the board
/MCU/RX_DATA: U2.10 (GPIO1); also elsewhere on the board
/MCU/RX_SDN: U2.1 (SDN); also elsewhere on the board
/MCU/SPI_MISO: U1.13 (SDO), U2.13 (SDO); also elsewhere on the board
/MCU/SPI_MOSI: U1.14 (SDI), U2.14 (SDI); also elsewhere on the board
/MCU/SPI_SCK: U1.12 (SCLK), U2.12 (SCLK); also elsewhere on the board
/MCU/TRX_CKL: U1.19 (GPIO2); also elsewhere on the board
/MCU/TRX_CS: U1.15 (~SEL); also elsewhere on the board
/MCU/TRX_DATA: U1.10 (GPIO1); also elsewhere on the board
/MCU/TRX_SDN: U1.1 (SDN); also elsewhere on the board
/Receiver/RF_IN: L16.2; also elsewhere on the board
/Receiver/TRX_OUT: U1.4 (TX); also elsewhere on the board
/Receiver/V_LNA: C3.1, L1.2, Q7.3 (D), TP13.1; also elsewhere on the board
GND: C1.2, C3.2, C5.2, C6.2, C7.1, C8.1, C9.1, C10.1, C11.1, C12.1, C37.2, U1.18 (GND), U1.21 (GND), U2.18 (GND), U2.21 (GND), U3.2 (GND), U3.4 (GND), U11.1, U11.2 (GND), U11.3, U11.5 (OUT_N), U11.6, U11.7, U11.8, U11.10 (IN_N), Y1.2, Y1.4, Y2.2, Y2.4; also elsewhere on the board
unnamed: C2.2, L15.1
unnamed: Q7.1 (G), R1.2
unnamed: R1.1, U1.20 (GPIO3)
unnamed: C5.1, L2.2, U1.3 (RXn)
unnamed: C4.1, L2.1, U1.2 (RXp)
unnamed: U1.17 (XIN), Y1.3
unnamed: U1.16 (XOUT), Y1.1
unnamed: C6.1, L3.2, U2.3 (RXn)
unnamed: C36.1, L3.1, U2.2 (RXp)
unnamed: U2.17 (XIN), Y2.3
unnamed: U2.16 (XOUT), Y2.1
unnamed: C2.1, U3.3 (RF-IN)
unnamed: C4.2, C36.2, L1.1, U3.1 (RF-OUT)
unnamed: C1.1, L16.1, U11.9 (IN_P)
unnamed: C37.1, L15.2, U11.4 (OUT_P)

Notes on the sheet:
MAIANA(TM) Transponder Board (c) 2016-2025 Maverick Labs LLC

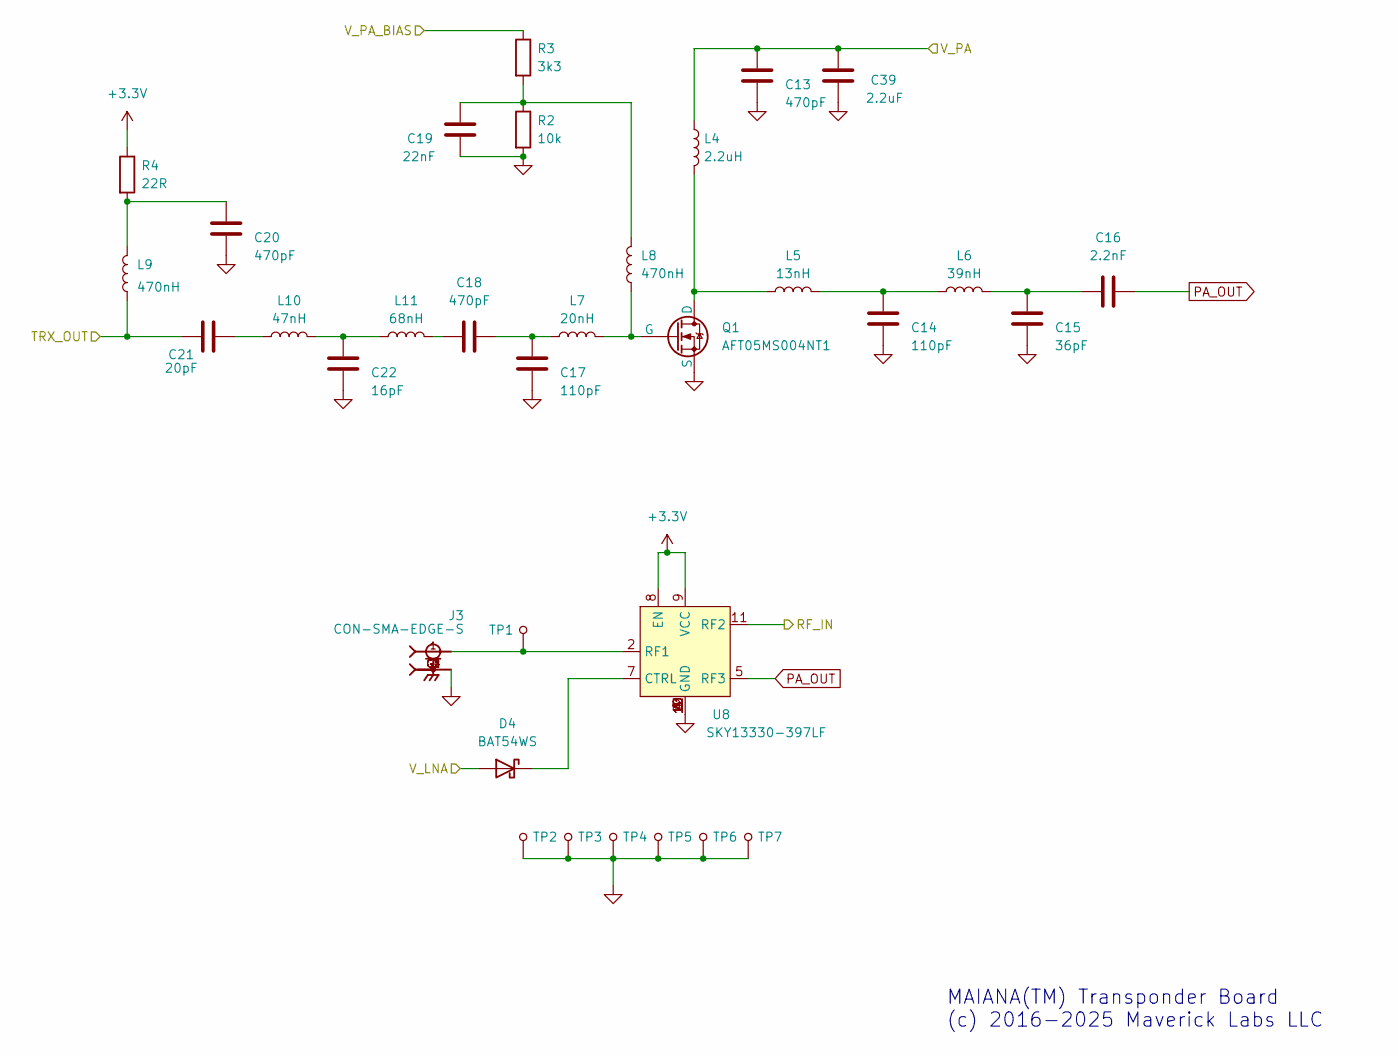
[picture p8: schematic tx.kicad_sch, Transmitter Amplifier and Antenna Switch]

Parts:
C13, C18, C20: 470pF; C_0603_1608Metric; LCSC C85979
C14, C17: 110pF; C_0603_1608Metric; LCSC C327208
C15: 36pF; C_0603_1608Metric; LCSC C134070
C16: 2.2nF; C_0603_1608Metric; LCSC C77033
C19: 22nF; C_0603_1608Metric; LCSC C106222
C21: 20pF; C_0603_1608Metric; LCSC C77030
C22: 16pF; C_0603_1608Metric; LCSC C327125
C39: 2.2uF; C_0603_1608Metric; LCSC C380321
D4: BAT54WS; D_SOD-323; LCSC C124205
J3: CON-SMA-EDGE-S; RFSOLUTIONS_CON-SMA-EDGE-S; PARTREV 1; DigiKey_Part_Number CON-SMA-EDGE-S-ND
L4: 2.2uH; L_0603_1608Metric; LCSC C55265173
L5: 13nH; L_0603_1608Metric; LCSC C701184
L6: 39nH; L_0603_1608Metric; LCSC C86134
L7: 20nH; L_0603_1608Metric; LCSC C77124
L8, L9: 470nH; L_0603_1608Metric; LCSC C113132
L10: 47nH; L_0603_1608Metric; LCSC C98076
L11: 68nH; L_0603_1608Metric; LCSC C86135
Q1: AFT05MS004NT1; SOT-89-3; LCSC C713822
R2: 10k; R_0603_1608Metric; LCSC C25804
R3: 3k3; R_0603_1608Metric; LCSC C22978
R4: 22R; R_0603_1608Metric; LCSC C23345
TP1: TP_1.0MM
TP2, TP3, TP4, TP5, TP6, TP7: TP_1.2MM
U8: SKY13330-397LF; QFN50P200X200X65-13N; LCSC C2654715

Connections:
+3.3V: R4.1, U8.8 (EN), U8.9 (VCC); also elsewhere on the board
/MCU/V_PA_BIAS: R3.1; also elsewhere on the board
/Power/V_PA: C13.2, C39.2, L4.1; also elsewhere on the board
/Receiver/RF_IN: U8.11 (RF2); also elsewhere on the board
/Receiver/TRX_OUT: C21.1, L9.1; also elsewhere on the board
/Receiver/V_LNA: D4.2 (A); also elsewhere on the board
GND: C13.1, C14.1, C15.1, C17.1, C19.1, C20.1, C22.1, C39.1, J3.G1, J3.G2, J3.G3, J3.G4, Q1.2 (S), R2.2, TP2.1, TP3.1, TP4.1, TP5.1, TP6.1, TP7.1, U8.1 (GND), U8.3 (GND), U8.4 (GND), U8.6 (GND), U8.10 (GND), U8.12 (GND), U8.13 (GND); also elsewhere on the board
unnamed: C14.2, L5.2, L6.1
unnamed: C15.2, C16.1, L6.2
unnamed: C17.2, C18.2, L7.1
unnamed: C18.1, L11.2
unnamed: C19.2, L8.2, R2.1, R3.2
unnamed: C20.2, L9.2, R4.2
unnamed: C21.2, L10.1
unnamed: C22.2, L10.2, L11.1
unnamed: D4.1 (K), U8.7 (CTRL)
unnamed: L4.2, L5.1, Q1.3 (D)
unnamed: L7.2, L8.1, Q1.1 (G)
unnamed: J3.1, TP1.1, U8.2 (RF1)
PA_OUT: C16.2, U8.5 (RF3)

Notes on the sheet:
MAIANA(TM) Transponder Board (c) 2016-2025 Maverick Labs LLC

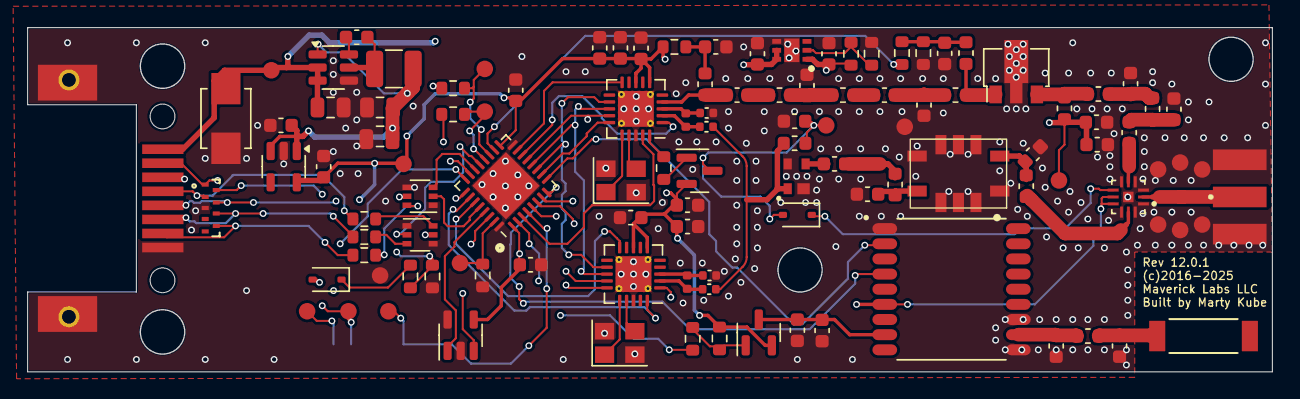
[picture p9: board transponder-12.0.1.kicad_pcb from above]

Board: 4 copper layers, 90.4 x 25.0 mm, 115 parts (1 on the bottom side), 81 nets.
