martykube/maiana/latest/CAD/NMEA2000Breakout/Rev8.1/NMEA2000Adapter-8.1.kicad_pcb

## KiCad design latest/CAD/NMEA2000Breakout/Rev8.1/NMEA2000Adapter-8.1.kicad_pcb (2026-11-01)

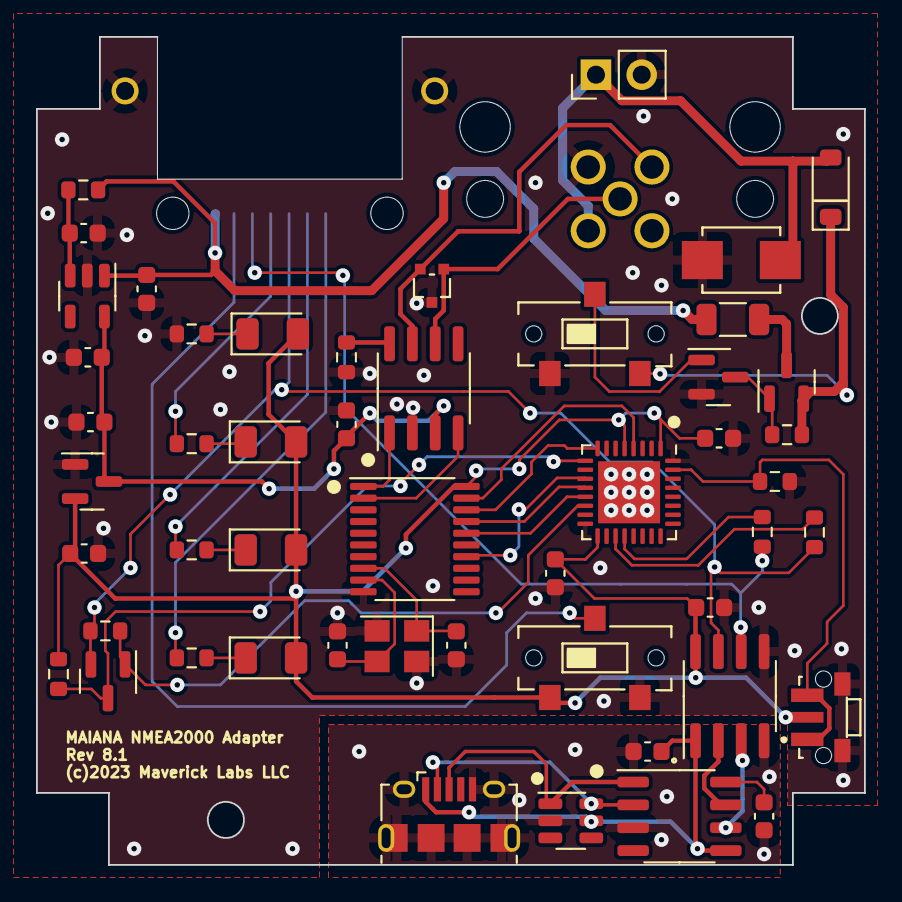
[picture p10: board NMEA2000Adapter-8.1.kicad_pcb from above]

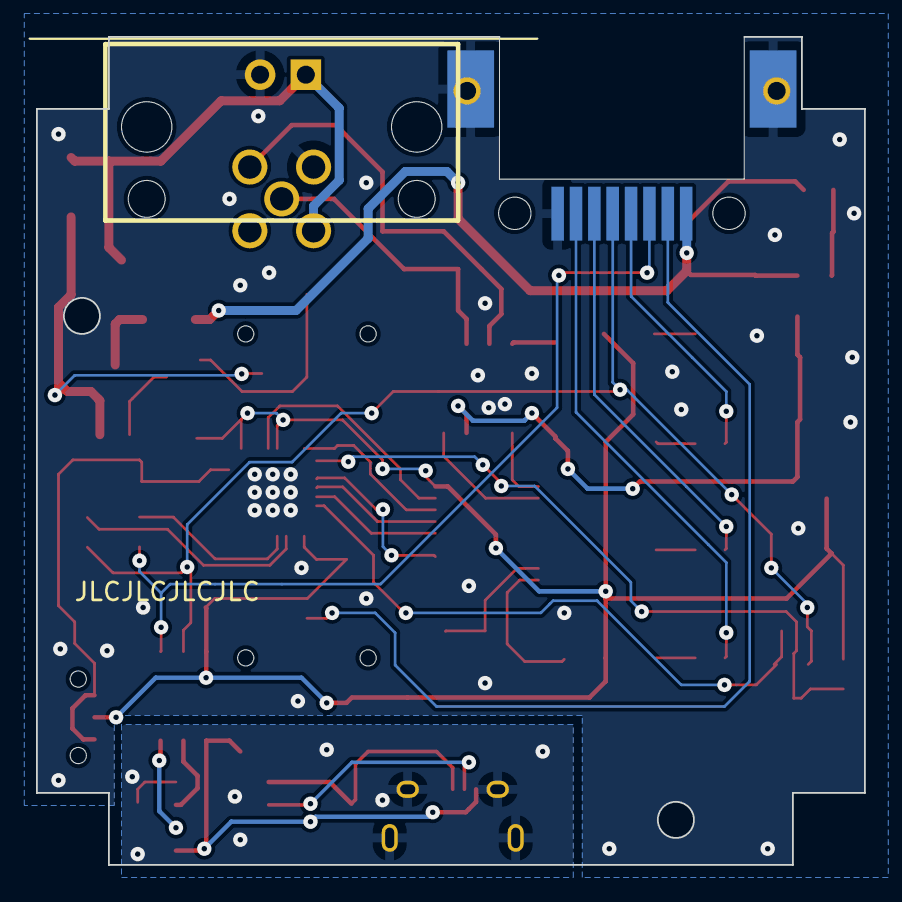
[picture p11: board NMEA2000Adapter-8.1.kicad_pcb from below]

Board: 2 copper layers, 46.0 x 46.0 mm, 52 parts (2 on the bottom side), 44 nets.

Parts:
C1, C2, C3, C11, C12, C13: 0.1uF; C_0603_1608Metric
C4, C5: 20pF; C_0603_1608Metric
C6, C7, C8, C9, C10: 1uF; C_0603_1608Metric
D1, D2, D3, D4: LED; LED_1206_3216Metric
D5: PESD1CAN-UX; SOT323
D6: SMBJ16CA; DIOM4336X265N
D8: B5819W; D_SOD-123
J1: 12-3701-05; MICRO_C_5PIN
J2: RJ-82A86MMNL
J3: USB_B_Micro; USB_Micro-B_Amphenol_10118194_Horizontal
J4: Conn_01x02; PinHeader_1x02_P2.54mm_Vertical
Q1, Q3: BSS138; SOT-23
Q2: AO3401A; SOT-23
R1, R2, R3, R4: 2k2; R_0603_1608Metric
R5, R6, R7, R8, R9, R10: 10k; R_0603_1608Metric
R11, R12: 0R; R_0603_1608Metric
SW1, SW2: CL-SB-12B-01; CL-SB-12B-01T
SW3: TS-1814; TE_1977066-1
TH1: BSMD1206-050-16V; R_1206_3216Metric
U1: STM32L432KBUx; QFN-32-1EP_5x5mm_P0.5mm_EP3.45x3.45mm
U2: MCP2515-xST; TSSOP-20_4.4x6.5mm_P0.65mm
U3: MCP2551-I-SN; SOIC-8_3.9x4.9mm_P1.27mm
U4: SRV05-4; SOT-23-6
U5: CH340N; SO-8_3.9x4.9mm_P1.27mm
U6: ISO7721DR; SOIC-8_3.9x4.9mm_P1.27mm
U7: TJ5205SF5-5.0; SOT-23-5
U8: SE8533X2-HF; SOT-23
Y1: X322516MOB4SI; Crystal_SMD_3225-4Pin_3.2x2.5mm

Connections:
+3.3V: C2.1, C10.1, C12.1, C13.1, D1.2 (A), D2.2 (A), D3.2 (A), D4.2 (A), R10.1, SW2.1, SW3.2, U1.1 (VDD), U1.5 (VDDA), U1.17 (VDD), U2.20 (VDD), U6.8 (VDD2), U8.2 (VO)
+5V: C8.1, C9.1, C11.1, U3.3 (VDD), U7.5 (OUT), U8.3 (VI)
+12V: D6.2, D8.2 (A), J1.2, J4.1
/CAN/CAN_H: D5.2, J1.4, U3.7 (CANH)
/CAN/CAN_L: D5.1, J1.5, U3.6 (CANL)
/CAN/NRST: U1.4 (NRST), U2.19 (~RESET)
/CAN/SPI_CS: U1.8 (PA2), U2.18 (~CS)
/CAN/SPI_MISO: U1.12 (PA6), U2.17 (SO)
/CAN/SPI_MOSI: U1.13 (PA7), U2.16 (SI)
/CAN/SPI_SCK: U1.11 (PA5), U2.14 (SCK)
/Connections/AIS_RX_EVENT: J2.P$6 (6), R3.2
/Connections/AIS_TX_EVENT: J2.P$7 (7), R4.2
/Connections/GPS_STATUS: J2.P$4 (4), R2.2
/Connections/MCU_UART_RX: R12.2, U1.20 (PA10)
/Connections/MCU_UART_TX: R11.2, U1.19 (PA9)
/Connections/TRANSPONDER_UART_TX: J2.P$5 (5), Q3.2 (S), R9.2, R11.1, U6.7 (VIA)
/Connections/TX_DISABLE: J2.P$2 (2), SW2.C
/Connections/V_OUT: C7.1, J2.P$1 (1), R6.1, TH1.1, U7.1 (IN)
/MCU/BOOT0: R8.1, SW3.1, SW3.3, U1.31 (PH3)
/Power/PWR_CTRL: Q1.1 (G), SW1.C
/Power/V_IN: D8.1 (K), Q2.2 (S), R5.1, SW1.3
CH340_RX: U5.7 (RX), U6.2 (VOA)
CH340_TX: U5.6 (TX), U6.3 (VIB)
D+: J3.3 (D+), U4.1 (IO1), U5.1 (D+)
D-: J3.2 (D-), U4.6 (IO4), U5.2 (D-)
GND: C2.2, C4.2, C5.2, C6.2, C7.2, C8.2, C9.2, C10.2, C11.2, C12.2, C13.2, D5.3, D6.1, J1.3, J2.P$8 (8), J2.P$9, J2.P$10, J2.P$11, J2.P$12, J4.2, Q1.2 (S), R1.2, R7.2, R8.2, SW1.1, SW2.3, SW3.S1 (SHIELD), SW3.S2 (SHIELD), U1.16 (VSS), U1.32 (VSS), U1.33 (VSS), U2.10 (VSS), U3.2 (VSS), U6.5 (GND2), U7.2 (GND), U8.1 (GND), Y1.2, Y1.4
GND2: C1.2, C3.2, J3.5 (GND), J3.6 (Shield), U4.2 (VN), U5.3 (GND), U6.4 (GND1)
NMEA_RX: Q3.3 (D), R10.2, U1.9 (PA3)
NMEA_RX_EN: Q3.1 (G), R9.1, U1.14 (PB0)
unnamed: D1.1 (K), R1.1
unnamed: D2.1 (K), R2.1
unnamed: D3.1 (K), R3.1
unnamed: D4.1 (K), R4.1
unnamed: Q1.3 (D), Q2.1 (G), R5.2
unnamed: Q2.3 (D), TH1.2
unnamed: U2.2 (RXCAN), U3.4 (RXD)
unnamed: U2.1 (TXCAN), U3.1 (TXD)
unnamed: R7.1, U3.8 (Rs)
unnamed: C1.1, U5.8 (V3)
unnamed: C6.1, R6.2, U7.3 (EN)
TRANSPONDER_UART_RX: J2.P$3 (3), R12.1, U6.6 (VOB)
VBUS: C3.1, J3.1 (VBUS), U4.5 (VP), U5.5 (VCC), U6.1 (VDD1)
XTL1: C5.1, U2.8 (OSC2), Y1.1
XTL2: C4.1, U2.9 (OSC1), Y1.3
