martykube/maiana/(commit log)

2026-11-01 Board 12.0.1: add LCSC part numbers and JLCPCB production files
    - Add LCSC field to every assembled part in the 12.0.1 schematic
    - Substitute out-of-stock parts: STM32L412KBU6 for K8U6 (same pinout),
    DMN63D8LDW-7 for SI1926DL (same pinout), FG RJ-055-1 for the RJ45
    - Fit J2 SWD header (was DNP) so new boards can be flashed
    - Add jlcpcb/ with Gerbers, BOM and CPL plus ordering notes
    [connections.kicad_sch, gnss.kicad_sch, mcu.kicad_sch, power.kicad_sch, rx.kicad_sch, transponder-12.0.1-BOM-JLCPCB.csv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]
2026-11-01 NMEA 0183 7.1 / NMEA 2000 8.1 adapters: LCSC part numbers and JLCPCB files
    Add LCSC fields to every assembled part, pick default-high isolator
    variants (ISO7721DR, ADuM121N1BRZ) so the transponder UART idles when USB
    is unplugged, swap the RJ45 to FG RJ-055-1 (drop-in for RJ-82A86MMNL),
    and add jlcpcb/ folders with Gerbers, BOM, CPL and order notes.
    [NMEA0183Adapter-7.1-B_Cu.gbl, NMEA0183Adapter-7.1-B_Mask.gbs, NMEA0183Adapter-7.1-B_Paste.gbp, NMEA0183Adapter-7.1-B_Silkscreen.gbo, NMEA0183Adapter-7.1-Edge_Cuts.gm1, NMEA0183Adapter-7.1-F_Cu.gtl, NMEA0183Adapter-7.1-F_Mask.gts, NMEA0183Adapter-7.1-F_Paste.gtp]
2026-11-01 Board 12.0.1: leave J2 (SWD) unfitted; program via pogo clip, top-side-only assembly
    [mcu.kicad_sch, transponder-12.0.1-BOM-JLCPCB.csv, transponder-12.0.1.kicad_pcb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]
2026-11-01 UART breakout 3.0: JLCPCB BOM/CPL from Peter's Eagle CAM output
    [uart-breakout-3.0-BOM-JLCPCB.csv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]
2026-11-01 Board 12.0.1: L4 = AFL160808-2R2MLH (0603 2.2uH, 1.4A) in place of 750mA placeholder
    Peter's 10.5 BOM used BRC2012T2R2MD (0805, ~1.1A) for the PA drain choke;
    12.0.1 has an 0603 footprint and TX bursts draw up to ~0.8A at V_PA 4.6V.
    [transponder-12.0.1-BOM-JLCPCB.csv, tx.kicad_sch]
2026-11-01 NMEA adapters: correct CPL rotations for JLCPCB part models
    Offsets verified in the JLCPCB placement preview for the NMEA 2000 8.1 board
    and applied to the matching packages on the NMEA 0183 7.1 board.
    [nmea0183-adapter-7.1-CPL-JLCPCB.csv, nmea2000-adapter-8.1-CPL-JLCPCB.csv]
2026-11-02 NMEA 0183 7.1: top-side RJ45 keeps KiCad rotation (verified in JLCPCB preview)
    [nmea0183-adapter-7.1-CPL-JLCPCB.csv]
2026-11-02 UART breakout 3.0: correct CPL rotations for U1, U$1, U$4 (verified in JLCPCB preview)
    [uart-breakout-3.0-CPL-JLCPCB.csv]
2026-11-02 Transponder firmware: headless Makefile for board 12.0.x (L412)
    Builds the L412-NewBreakouts(-Bootloader) configurations outside Eclipse.
    Defaults to the xPack arm-none-eabi-gcc 15.2.1 toolchain; Ubuntu's GCC 13.2
    overflows the 56 KB bootloader app area. Ignore the build/ output directory.
2026-11-06 Board 12.0.1: correct CPL rotations for JLCPCB part models; update parts sourcing
    Rotations checked in the JLCPCB placement preview. AE1, J3, U11, Y1 and Y2 can't
    be previewed until they are in My Parts Lib. README records the sourcing route
    for those parts.
    [transponder-12.0.1-CPL-JLCPCB.csv]
2026-11-06 Board 12.0.1: add builder credit to front silkscreen
    Add "Built by Marty Kube" below the Maverick Labs notice and move the
    text block down 0.4 mm to stay clear of the ground pour. Revision stays
    12.0.1: copper and netlist are unchanged. Only the F.SilkS Gerber is
    regenerated in the JLCPCB zip.
    Claude-Session: https://claude.ai/code/session_01Qq5ZY1PWh98D1cYRYngyN6
    [transponder-12.0.1.kicad_pcb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]
2026-11-06 Board 12.0.1: add back silkscreen art and bench notes
    Add a compass rose, a "HERE BE DRAGONS" sea serpent, an RJ45 pinout and
    CLI notes, and an AIS type 14 sentence, all on B.SilkS. Revision stays
    12.0.1: copper and netlist are unchanged. Only the B.SilkS Gerber is
    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
    [transponder-12.0.1.kicad_pcb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]
2026-11-06 Board 12.0.1: add write-on box and chart disclaimer to back silkscreen
    Add a solid silkscreen box for a unit name or serial, and a "NOT TO BE
    USED FOR NAVIGATION" line under the sea serpent. Copper and netlist are
    unchanged. Only the B.SilkS Gerber is regenerated in the JLCPCB zip.
    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
    [transponder-12.0.1.kicad_pcb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]
2026-11-07 Add through-hole solder practice board
    100x76 mm 2-layer board with resistor, header, DIP-8, thermal relief,
    terminal block, button, RJ45 and M12 practice sections using the real
    Maiana footprints. Generated by generate.py; JLC Gerber zip included.
    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
    [solder-practice-B_Cu.gbl, solder-practice-B_Mask.gbs, solder-practice-B_Paste.gbp, solder-practice-B_Silkscreen.gbo, solder-practice-Edge_Cuts.gm1, solder-practice-F_Cu.gtl, solder-practice-F_Mask.gts, solder-practice-F_Paste.gtp]
2026-11-08 Board 12.0.1: fit SWD header J2 on the bottom side
    Add Samtec FTSH-105-01-L-DV-K-TR (C448647) to the JLCPCB BOM and CPL so
    every board can take the bootloader over SWD with a 10-pin cable. A
    1.27 mm pogo clip lands just inside the SMD header pads. README updated
    for two-sided assembly; J2's bottom rotation still needs checking in the
    preview.
    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
    [transponder-12.0.1-BOM-JLCPCB.csv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]
