martykube/maiana/(notices)

Notices in the files:
latest/CAD/NMEA0183Breakout/Rev7.1/NMEA0183Adapter-7.1.kicad_pcb:
(c)2024 Maverick Labs LLC
latest/CAD/NMEA2000Breakout/Rev8.1/NMEA2000Adapter-8.1.kicad_pcb:
(c)2023 Maverick Labs LLC
parts and their libraries:
COPYRIGHT: Copyright (C) 2021 Ultra Librarian. All rights reserved.
